osprey-dcs/ttl-io/README.md

# Osprey Quartz LVTTL I/O Daughter Board

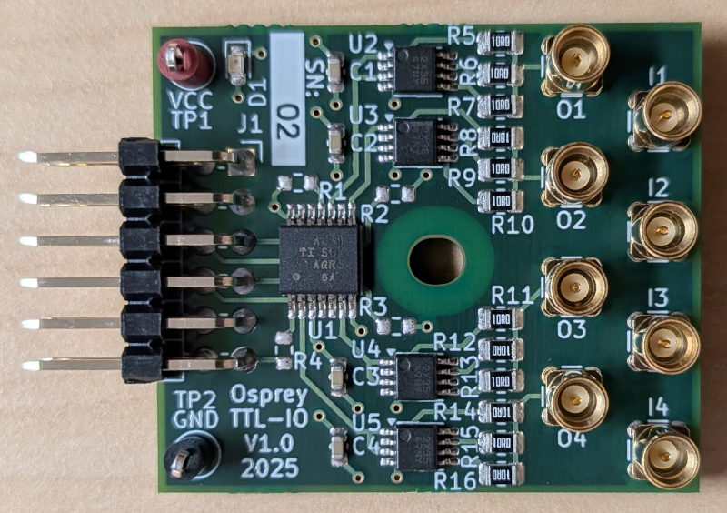
[picture p1: lvttl-io.png]


A PMOD compatible board providing 4 input and 
4 output bits of LVTTL binary I/O.
Intended to be used with LBL [Marble](https://github.com/BerkeleyLab/Marble).

* [Current design](https://osprey-dcs.github.io/ttl-io) information.
