osprey-dcs/ttl-io/ttl-io.kicad_pcb

## KiCad design ttl-io.kicad_pcb (2025-11-15)

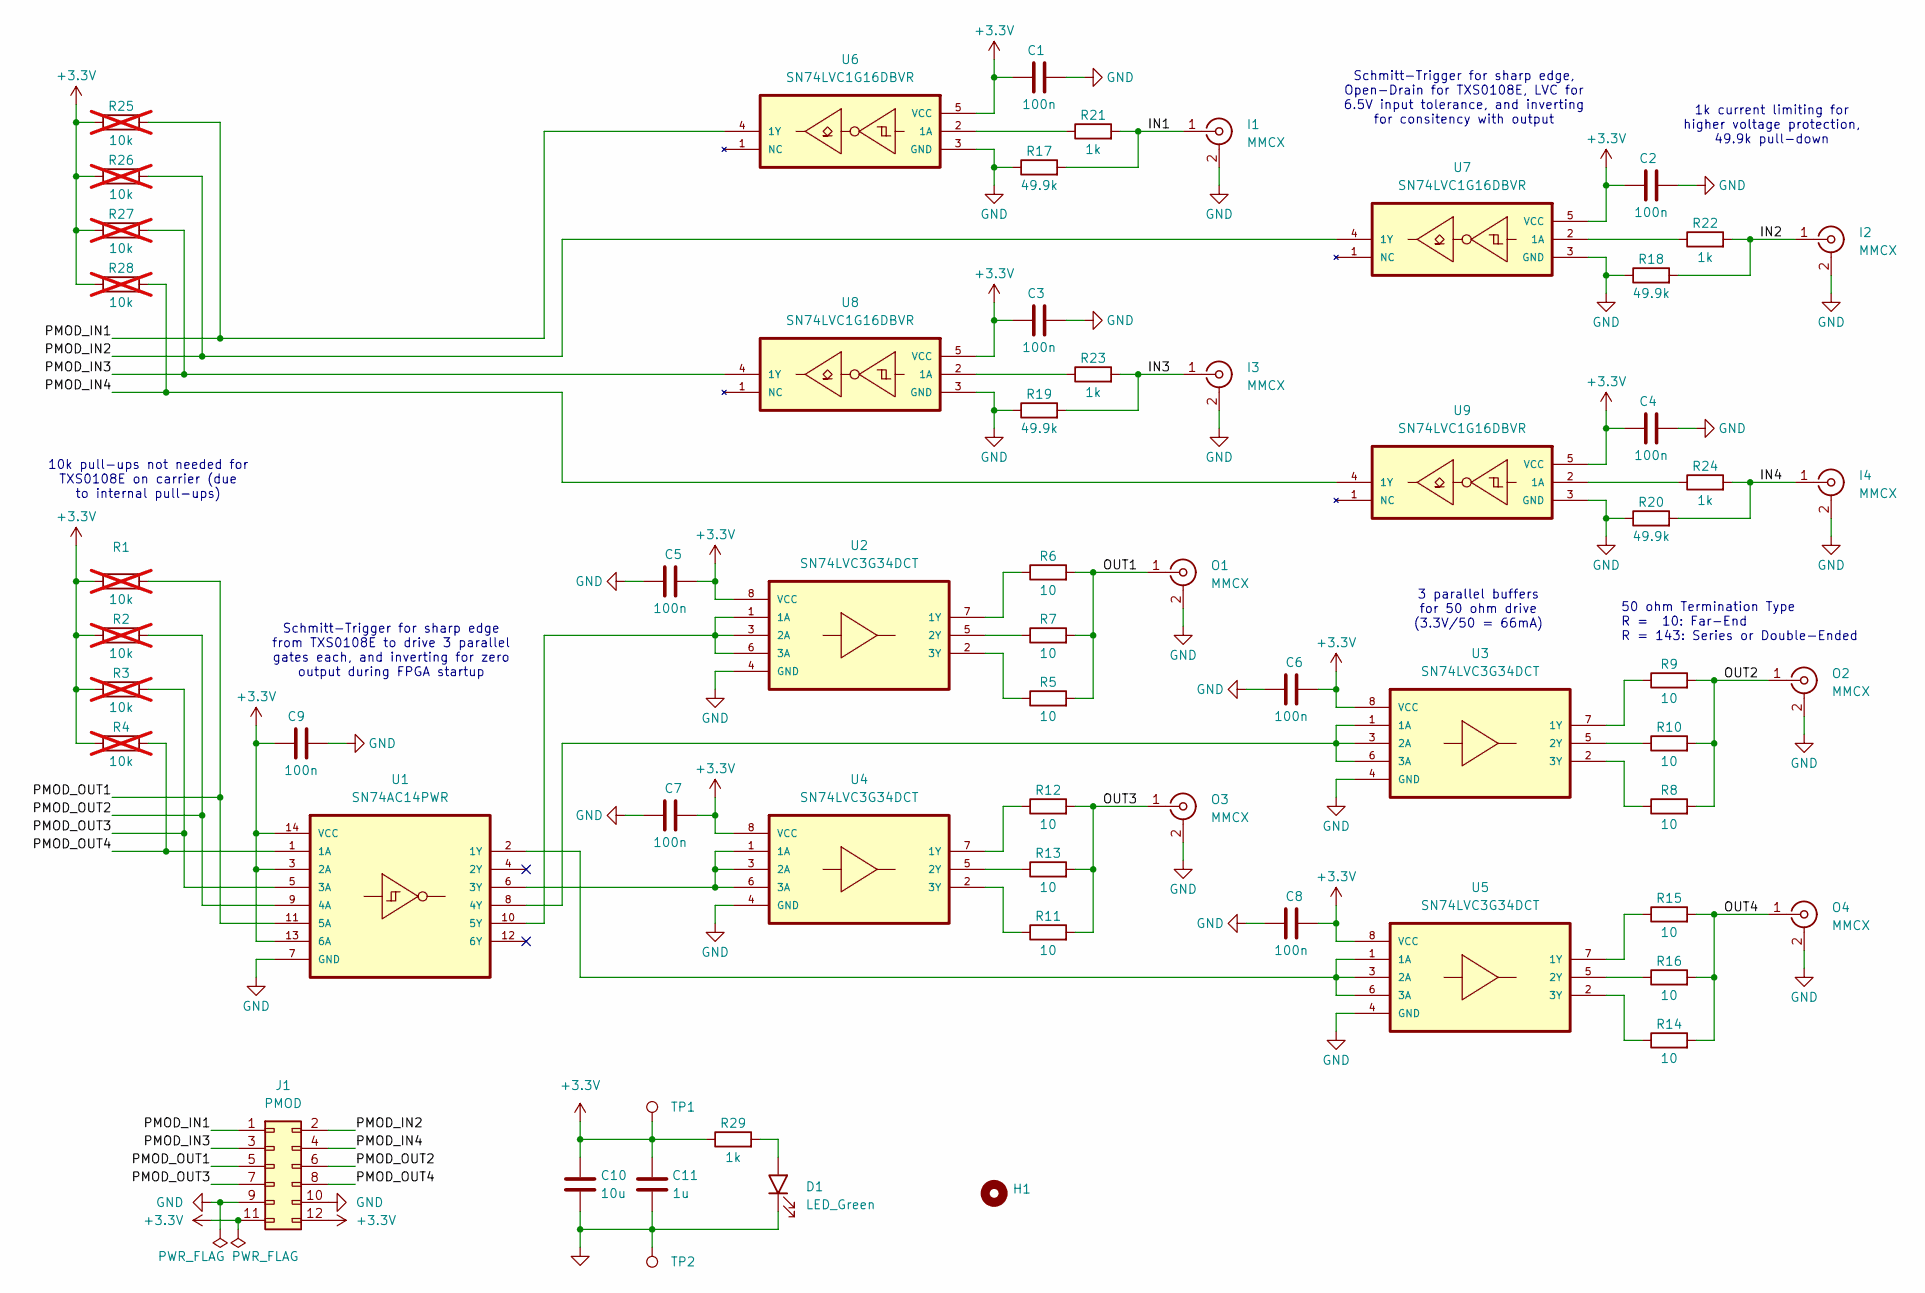
[picture p2: schematic ttl-io.kicad_sch, LVTTL PMOD]

Parts:
C1, C2, C3, C4, C5, C6, C7, C8, C9: 100n; C_0603_1608Metric; MPN CL10B104KB8NNWC; Digikey 1276-1935-2-ND
C10: 10u; C_0805_2012Metric; MPN GRM21BR61E106KA73L; Digikey 490-5523-2-ND
C11: 1u; C_0603_1608Metric; MPN CC0603KRX7R7BB105; Digikey 311-1446-2-ND
D1: LED_Green; LED_0603_1608Metric; MPN APT1608CGCK; Digikey 754-1116-2-ND
H1: Mounting_Hole_Slot
I1, I2, I3, I4: MMCX; MMCX_THT_Vertical; MPN MMCX-J-P-H-ST-TH1; Digikey SAM10617-ND
J1: PMOD; PMOD_2x06_P2.54mm_Mirrored; MPN PH2RA-12-UA; Digikey 2057-PH2RA-12-UA-ND
O1, O2, O3, O4: MMCX; MMCX_THT_Vertical; MPN MMCX-J-P-H-ST-TH1; Digikey SAM10617-ND
R1, R2, R3, R4, R25, R26, R27, R28: 10k; R_0603_1608Metric; MPN RC0603FR-0710KL; Digikey 311-10.0KHRCT-ND; not fitted
R5, R6, R7, R8, R9, R10, R11, R12, R13, R14, R15, R16: 10; R_0805_2012Metric; MPN RC0805FR-1010RL; Digikey 13-RC0805FR-1010RLTR-ND
R17, R18, R19, R20: 49.9k; R_0603_1608Metric; MPN RC0603FR-1349K9L; Digikey 13-RC0603FR-1349K9LTR-ND
R21, R22, R23, R24, R29: 1k; R_0603_1608Metric; MPN RC0603FR-071KP; Digikey YAG1294TR-ND
TP1: TestPointRed; TestPoint_Loop_D1.80mm_Drill1.0mm_Beaded; MPN 5000; Digikey 36-5000-ND
TP2: TestPointBlack; TestPoint_Loop_D1.80mm_Drill1.0mm_Beaded; MPN 5001; Digikey 36-5001-ND
U1: SN74AC14PWR; SN74AC1xPWR; MPN SN74AC14PWR; Digikey 296-4302-1-ND
U2, U3, U4, U5: SN74LVC3G34DCT; MPN SN74LVC3G34DCTR; Digikey 296-13285-1-ND
U6, U7, U8, U9: SN74LVC1G16DBVR; MPN SN74LVC1G16DBVR; Digikey 296-SN74LVC1G16DBVRCT-ND

Connections:
+3.3V: C1.2, C2.2, C3.2, C4.2, C5.2, C6.2, C7.2, C8.2, C9.2, C10.1, C11.1, J1.11, J1.12, R1.1, R2.1, R3.1, R4.1, R25.1, R26.1, R27.1, R28.1, R29.1, TP1.1, U1.3 (2A), U1.13 (6A), U1.14 (VCC), U2.8 (VCC), U3.8 (VCC), U4.8 (VCC), U5.8 (VCC), U6.5 (VCC), U7.5 (VCC), U8.5 (VCC), U9.5 (VCC)
/IN1: I1.1 (In), R17.2, R21.2
/IN2: I2.1 (In), R18.2, R22.2
/IN3: I3.1 (In), R19.2, R23.2
/IN4: I4.1 (In), R20.2, R24.2
/OUT1: O1.1 (In), R5.2, R6.2, R7.2
/OUT2: O2.1 (In), R8.2, R9.2, R10.2
/OUT3: O3.1 (In), R11.2, R12.2, R13.2
/OUT4: O4.1 (In), R14.2, R15.2, R16.2
/PMOD_IN1: J1.1, R25.2, U6.4 (1Y)
/PMOD_IN2: J1.2, R26.2, U7.4 (1Y)
/PMOD_IN3: J1.3, R27.2, U8.4 (1Y)
/PMOD_IN4: J1.4, R28.2, U9.4 (1Y)
/PMOD_OUT1: J1.5, R1.2, U1.11 (5A)
/PMOD_OUT2: J1.6, R2.2, U1.9 (4A)
/PMOD_OUT3: J1.7, R3.2, U1.5 (3A)
/PMOD_OUT4: J1.8, R4.2, U1.1 (1A)
GND: C1.1, C2.1, C3.1, C4.1, C5.1, C6.1, C7.1, C8.1, C9.1, C10.2, C11.2, D1.1 (K), I1.2 (Ext), I2.2 (Ext), I3.2 (Ext), I4.2 (Ext), J1.9, J1.10, O1.2 (Ext), O2.2 (Ext), O3.2 (Ext), O4.2 (Ext), R17.1, R18.1, R19.1, R20.1, TP2.1, U1.7 (GND), U2.4 (GND), U3.4 (GND), U4.4 (GND), U5.4 (GND), U6.3 (GND), U7.3 (GND), U8.3 (GND), U9.3 (GND)
unnamed: D1.2 (A), R29.2
unnamed: U1.2 (1Y), U5.1 (1A), U5.3 (2A), U5.6 (3A)
unnamed: U1.6 (3Y), U4.1 (1A), U4.3 (2A), U4.6 (3A)
unnamed: U1.8 (4Y), U3.1 (1A), U3.3 (2A), U3.6 (3A)
unnamed: U1.10 (5Y), U2.1 (1A), U2.3 (2A), U2.6 (3A)
unnamed: R6.1, U2.7 (1Y)
unnamed: R7.1, U2.5 (2Y)
unnamed: R5.1, U2.2 (3Y)
unnamed: R9.1, U3.7 (1Y)
unnamed: R10.1, U3.5 (2Y)
unnamed: R8.1, U3.2 (3Y)
unnamed: R12.1, U4.7 (1Y)
unnamed: R13.1, U4.5 (2Y)
unnamed: R11.1, U4.2 (3Y)
unnamed: R15.1, U5.7 (1Y)
unnamed: R16.1, U5.5 (2Y)
unnamed: R14.1, U5.2 (3Y)
unnamed: R21.1, U6.2 (1A)
unnamed: R22.1, U7.2 (1A)
unnamed: R23.1, U8.2 (1A)
unnamed: R24.1, U9.2 (1A)

Notes on the sheet:
Schmitt-Trigger for sharp edge from TXS0108E to drive 3 parallel gates each, and inverting for zero output during FPGA startup
Schmitt-Trigger for sharp edge, Open-Drain for TXS0108E, LVC for 6.5V input tolerance, and inverting for consitency with output
10k pull-ups not needed for TXS0108E on carrier (due to internal pull-ups)
3 parallel buffers for 50 ohm drive (3.3V/50 = 66mA)
50 ohm Termination Type R = 10: Far-End R = 143: Series or Double-Ended
1k current limiting for higher voltage protection, 49.9k pull-down

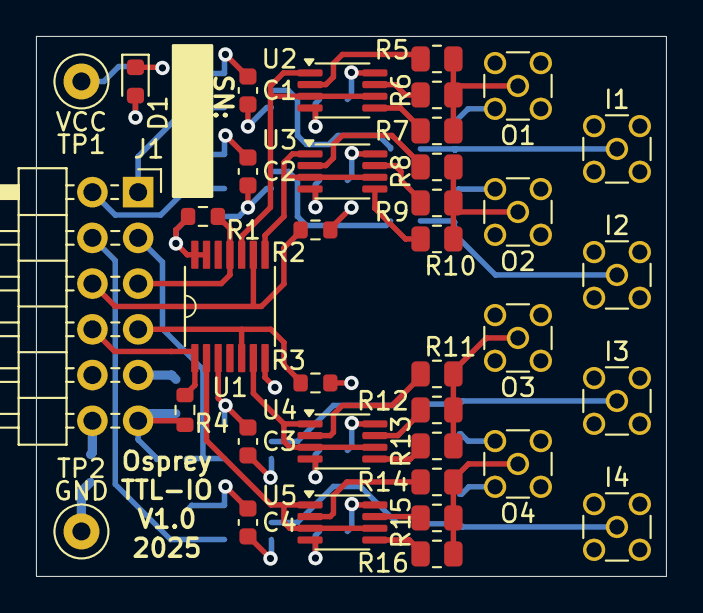
[picture p3: board ttl-io.kicad_pcb from above]

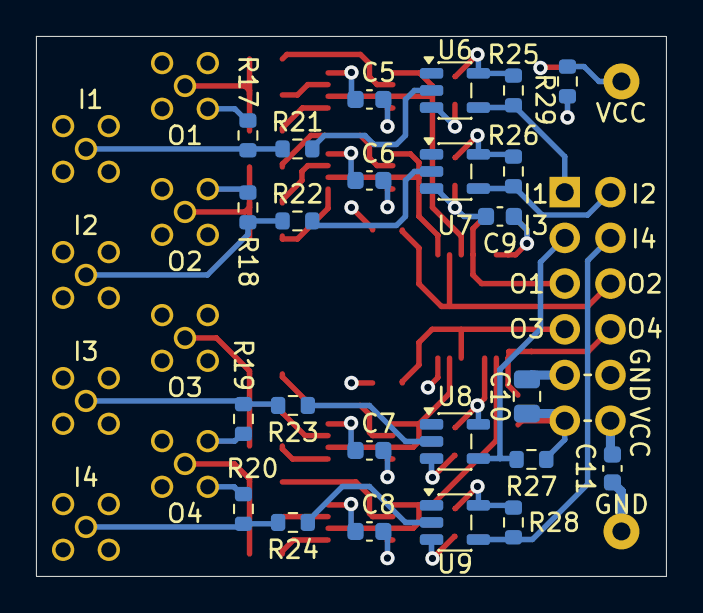
[picture p4: board ttl-io.kicad_pcb from below]

Board: 4 copper layers, 35.0 x 30.0 mm, 62 parts (24 on the bottom side), 39 nets.
