osprey-dcs/ttl-io/(commit log)

2025-10-22 Passed DRC, ready to build?
    [pmod-io.kicad_pcb, pmod-io.kicad_sch]
2025-10-23 Ready for review
    [ttl-io.kicad_pcb, ttl-io.kicad_sch]
2025-10-25 Updated part values/#s
    [ttl-io.kicad_pcb, ttl-io.kicad_sch]
2025-10-28 Updated sch notes and part info, ready for fab
    [ttl-io.kicad_pcb, ttl-io.kicad_sch]
2025-10-29 switch to unix eol
    [ttl-io.kicad_pcb, ttl-io.kicad_sch]
2025-10-29 add title and copyright/license
    adjust PCB page size to US letter
    [ttl-io.kicad_pcb, ttl-io.kicad_sch]
2025-10-29 set silk/paste colors
    [ttl-io.kicad_pcb]
2025-10-29 add 3d model for I/O connector
    [ttl-io.kicad_pcb]
2025-10-29 add wire harness sub-project
    [io-cable.kicad_pcb, io-cable.kicad_sch]
2025-10-29 pcb tweaks, date/ver, U5 3D model, 0.4mm holes
    [ttl-io.kicad_pcb, ttl-io.kicad_sch]
2025-10-29 update io-cable
    [io-cable.kicad_sch]
2025-11-04 30x35mm version initial commit
    [ttl-io.kicad_pcb, ttl-io.kicad_sch]
2025-11-04 initial 30mm x 35mm STEP file
    [ttl-io.step]
2025-11-05 swapped I/O MMCX columns
    [ttl-io.kicad_pcb]
2025-11-11 slotted mounting hole
    [ttl-io.kicad_pcb, ttl-io.kicad_sch]
2025-11-12 Updated 0805 resistor part #
    [ttl-io.kicad_pcb, ttl-io.kicad_sch]
2025-11-12 Fixed 10 ohm res part #
    [ttl-io.kicad_pcb, ttl-io.kicad_sch]
2025-11-15 switch EoL to CRLF
2025-11-15 set ENIG finish
    [ttl-io.kicad_pcb]
2025-11-15 drop out of date io-cable
    [io-cable.kicad_pcb, io-cable.kicad_sch]
