osprey-dcs/ttl-io/(notices)

Notices in the files:
ttl-io.kicad_pcb:
SPDX-FileCopyrightText: 2025 Osprey DCS
SPDX-License-Identifier: CERN-OHL-S-2.0+
